elutsk/baby-bath-monitor/docs/images/prototype_back.jpg

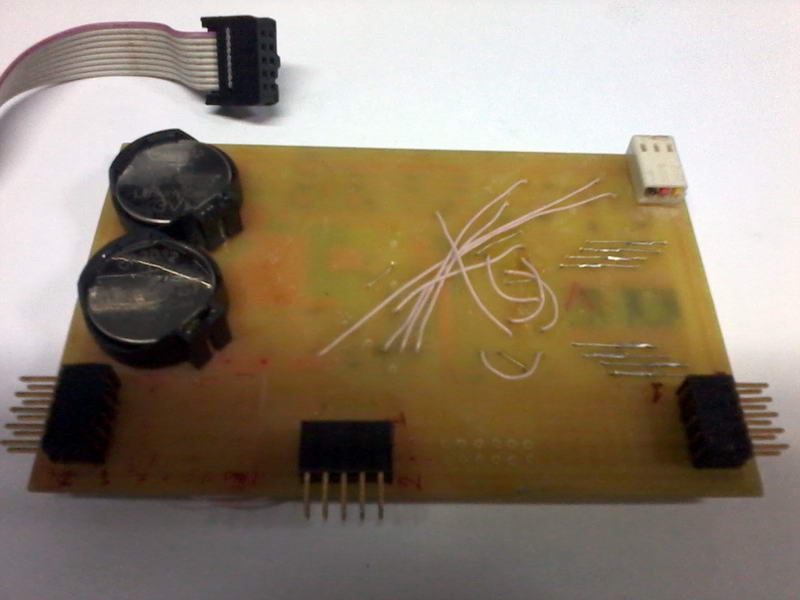
docs/images/prototype_back.jpg
