elutsk/baby-bath-monitor/hardware/P-CAD/old versions/2.1/scheme2_1.xls

номер элемента | название | тип | колич.
R1-R5,R7-R9 | резисторы 0,1W 5% | 560 Om | 8
R6,R15,R17,R19,R20,R21 | - | 10 kOm | 6
R10,R11 | - | 100 kOm | 2
R12 | - | 2,2 kOm | 1
R13 | - | 3 MOm | 1
R14 | - | 200 kOm | 1
R16 | - | 9,1 kOm | 1
R18 | - | 8,2 kOm | 1
R22,R24,R25 | - | 100 Om | 3
R23 | - | 7,5 kOm | 1
 | конденсаторы
C1-C3 | электролит. | 10 mkF 10V | 3
C4,C7 | электролит. | 1 mkF 10V | 2
C5,C6,C8,C9 | керам. | 0,1 mkF | 4
C10 | керам. | 1000pF | 1
L1 | дроссель
 | 10mkH SMD_1210 | LQH32CN100K23L | 1
BUZ1 | звукоизлучатель
 | 3v 5mA 4kHz 75db 16x16mm 120`C max | HPS16A | 1
 | диоды
VD1,VD2,VD4-VD7 | сборка 2 диода SOT23 | BAV99 | 3
VD3 | SOD80 | FDLL4148_D87Z | 1
H1-H3 | св.индикаторы
 | SMD 10x6,9x3mm | KCSA02-102, KCSC02-102 | 3
VT1-VT3 | транзисторы пол.
 | SOT23 | IRLML6302TRPBF | 3
ST1 (termosensor) | датчик темп.
 | TO92 | LM35DZ/NOPB | 1
U1 | микроконтроллер
 | Atmel | ATTINY261A (SOIC/DIP) | 1
BAT1,BA2 | Батарейный отсек
 | CR2032 | SN2032 | 2
S1-S5 | кнопки
 | SMD 6x6mm | TACTM-64N-F | 5
