elutsk/baby-bath-monitor/(list of files, cad)

Other CAD files:
firmware/old versions/4.0/hex/tempsens0.obj
