elutsk/baby-bath-monitor/(list of files, drawings)

Other design files:
hardware/Altium/schem5.SchLib
hardware/Altium/Sheet1.SCHDOC
hardware/P-CAD/old versions/2.2/pcb43x48back4.pcb
hardware/P-CAD/old versions/3.1/pcb3_1.pcb
hardware/P-CAD/old versions/4.0/pcb3_1.pcb
hardware/P-CAD/old versions/4.3/PCB_4.3.pcb
hardware/P-CAD/old versions/4.4/PCB_4.4_1.pcb
hardware/P-CAD/old versions/5.0/PCB_5.pcb
hardware/pcb.pcb
