elutsk/baby-bath-monitor/(commit log)

2026-09-25 Readme updated. Altium schematics import
    [Sheet1.SCHDOC, schem5.PrjPcb, schem5.SchLib]
2026-09-25 Older versions of hardware and firmware added
    [PCB_4.3.pcb, PCB_4.4_1.pcb, PCB_5.pcb, pcb.pcb, pcb3_1.pcb, pcb43x48back4.pcb, schem.sch, schem1.sch]
